Robotto/CO2gauge/README.md

# CO2gauge
A gauge that shows how much of the gridmix is carbon neutral based on data from [co2signal.com](https://co2signal.com).

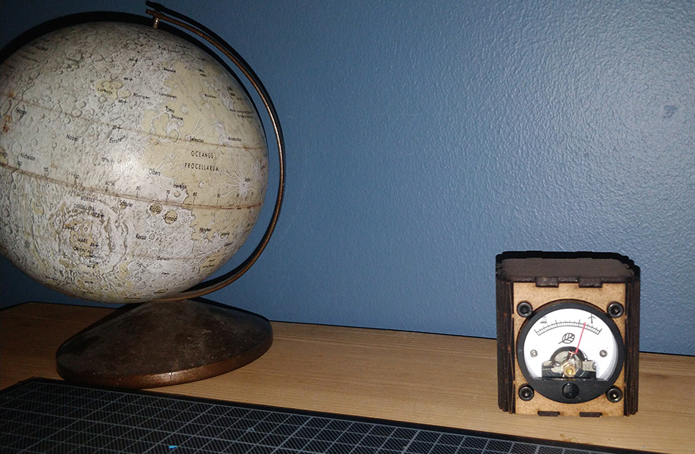
[picture p1: readme_images/getup.jpg]
Image of the thing


I'm aware that wind power is not the only carbon neutral power source, but it looks neat with a windmill there, and it kind of rings true at least in Denmark where I'm from. 

# API usage and key
Get your own from [co2signal.com](https://www.co2signal.com/) for free! Check  [electricitymap.org](https://www.electricitymap.org/) for your grid ID (country code), or the [co2signal.com](https://www.co2signal.com/) docs for how to do a lookup using lat/lon instead of grid ID.

# Hardware
ESP8266 running Arduino on a Wemos D1 mini board.

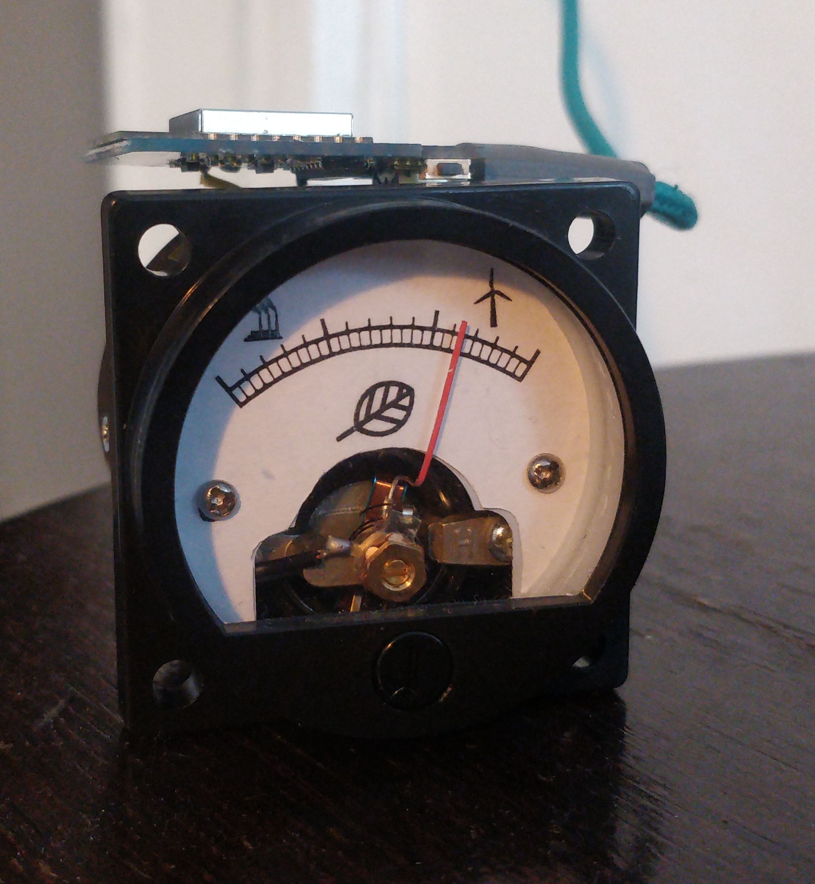
[picture p2: readme_images/CO2gauge.jpg]
Image of the thing


Gauges are from [ebay](https://www.ebay.com/itm/Black-Voltmeter-SO-45-AC-0-300V-Round-Analog-Dial-Panel-Meter-Voltmeter-Gauge/312322530464). I have replaced the 100K resistor inside with a 1K resistor to change the max voltage to ~3V, thus enabling direct PWM control of the gauge.
The needle was kind of pale when I got the thing, so I painted it red while I had it open.

# Box
The box design is based on [bdahlem's amazing parametric flexbox postscript file](https://www.thingiverse.com/thing:17240). It is lasercut from 3mm MDF and holds itself together quite neatly.

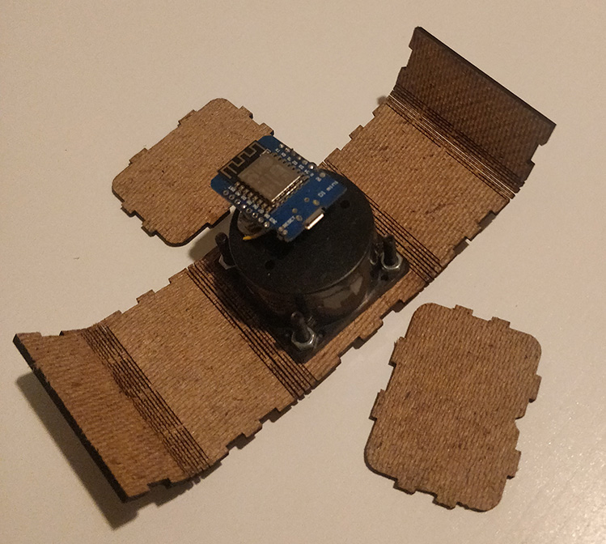
[picture p3: readme_images/flap.jpg]
flap

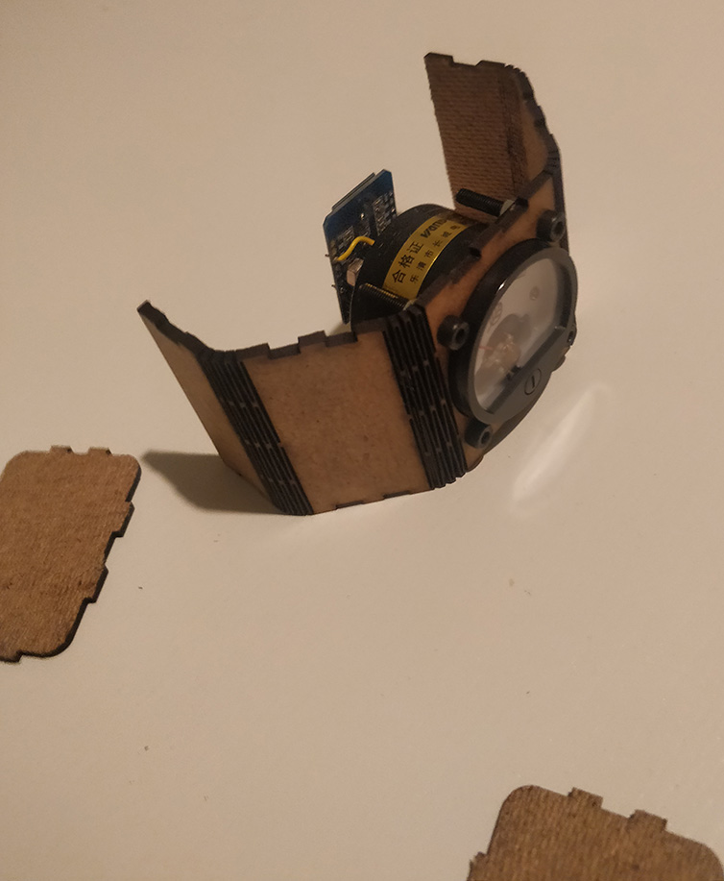
[picture p4: readme_images/flip.jpg]
flip

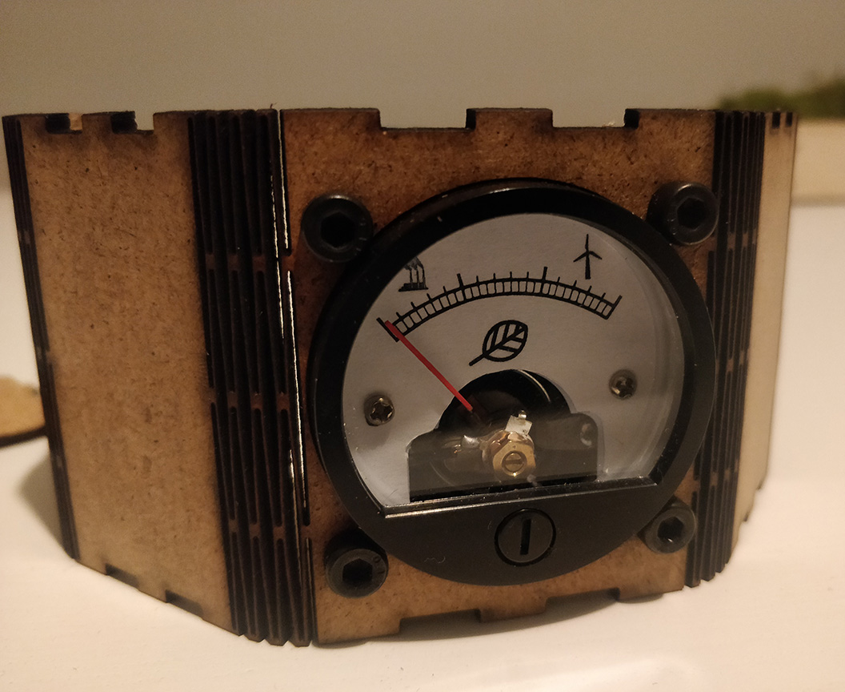
[picture p5: readme_images/closeup.jpg]
closeup
