Robotto/CO2gauge/co2_flexbox.ai.pdf

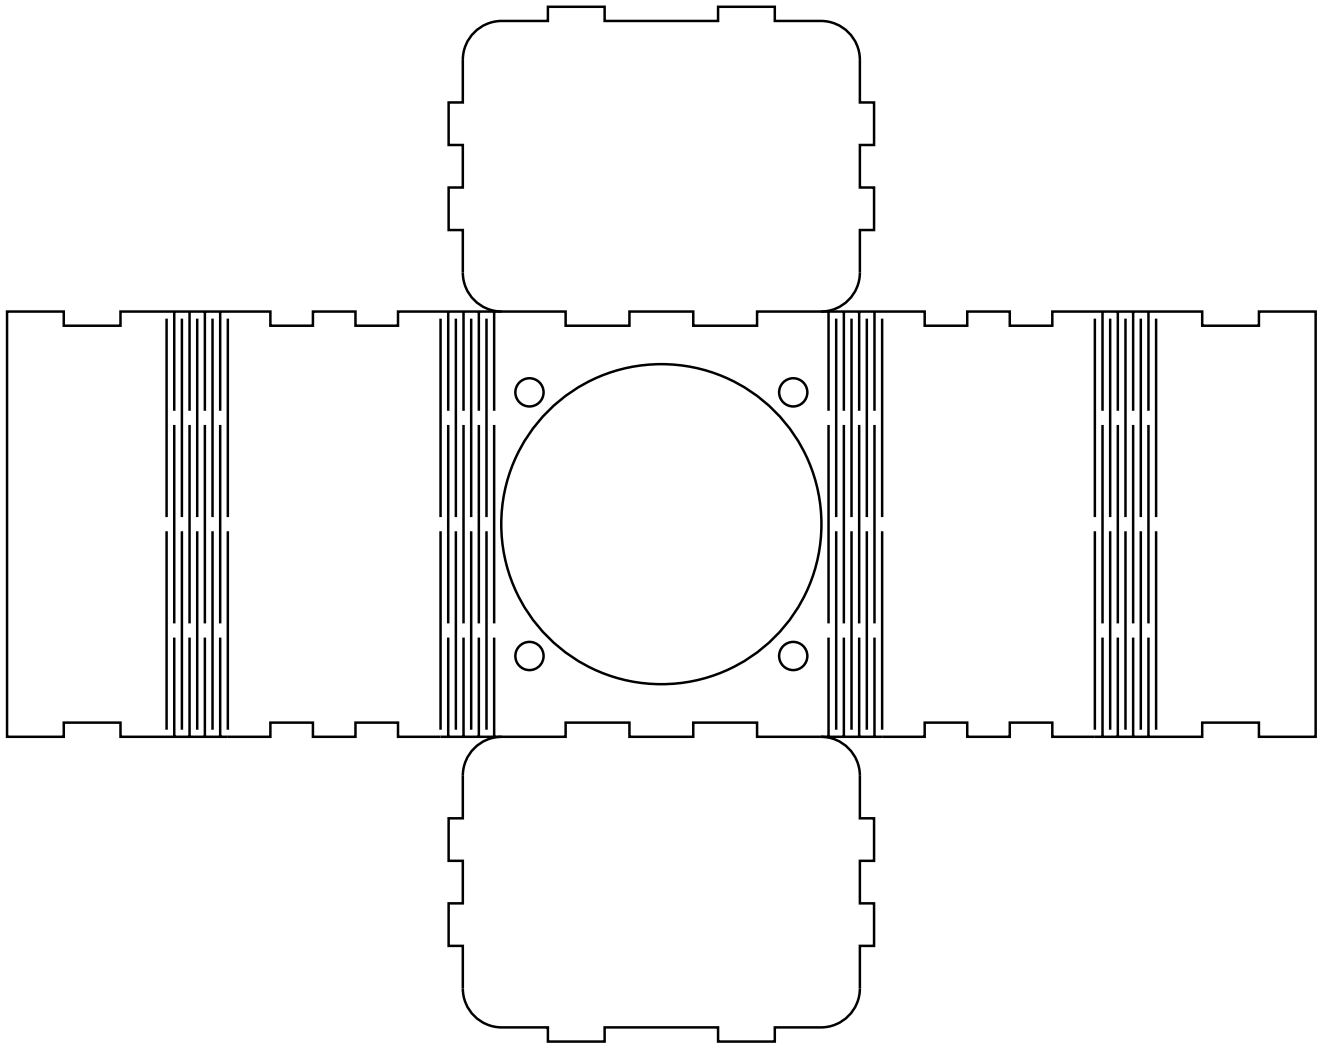
[picture p6: figure]
