Robotto/CO2gauge/co2_gauge.ai.pdf

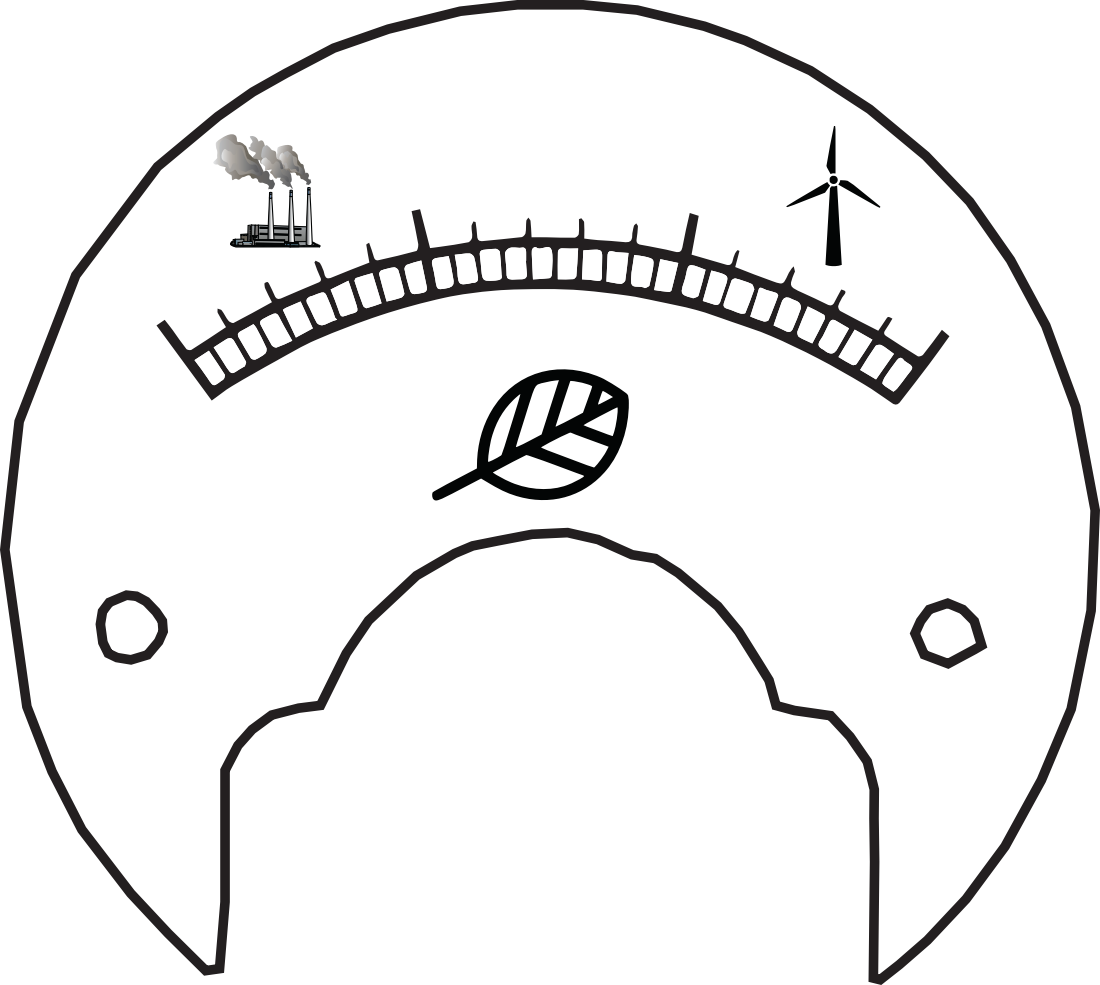
[picture p7: page 1]
